jamesjomuad/laser-counter/docs/diagrams/tlc555.jpg

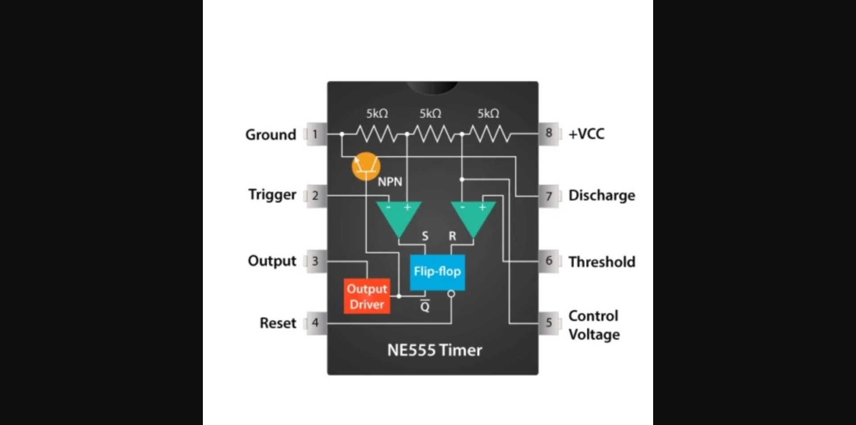
docs/diagrams/tlc555.jpg
