jamesjomuad/laser-counter/docs/diagrams/Monosnap wiring_diagram.svg - Google Chrome 2026-0.jpg

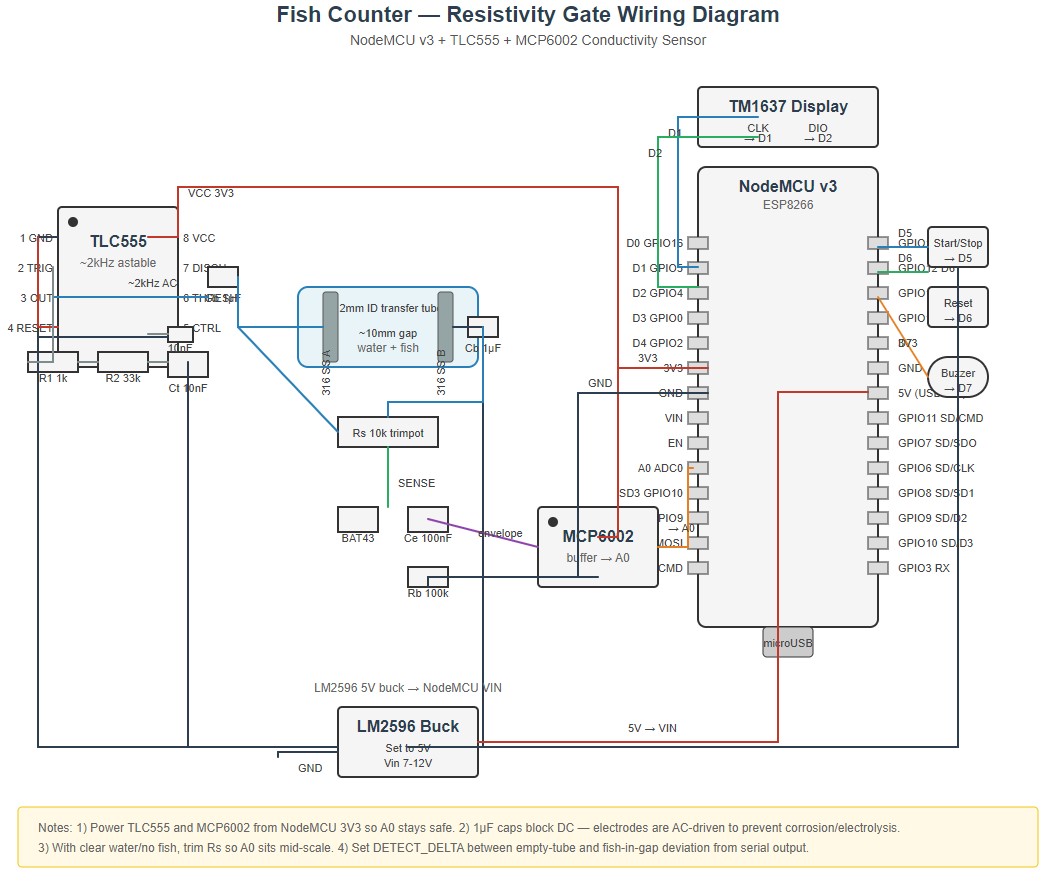
docs/diagrams/Monosnap wiring_diagram.svg - Google Chrome 2026-0.jpg
