jamesjomuad/laser-counter/(commit log)

2026-06-03 Initial commit: laser beam counter for ESP8266
2026-06-14 Switch sensor from laser beam-break to conductivity gate
    Replace the laser/LDR beam-break sensor with an electrical conductivity
    (resistivity) gate for counting tilapia fingerlings through a 12mm
    water-filled tube, where the laser refracts and translucent fish don't
    reliably break the beam.
    - Detection: self-calibrating baseline + deviation (DETECT_DELTA) with a
    sustained-clear re-arm, replacing the fixed THRESHOLD
    - Add resistivity_sensor.md (electrode/circuit design + BOM)
    - Update CLAUDE.md and pins.md: hardware table, pin map, API routes,
    constants, and the previously-undocumented D5 start/stop button
2026-07-10 Rename AP to FishCounter-Setup, add serial RESETWIFI command, disable captive portal, add developer credit to dashboard
    - Rename WiFi AP from LaserCounter-Setup to FishCounter-Setup
    - Add RESETWIFI/CLEARWIFI serial command to clear saved WiFi credentials
    - Add clearWifiSettings() function to wifi_dashboard
    - Disable WiFiManager captive portal so custom dashboard serves at 192.168.4.1
    - Add 'Developed by James' credit to web dashboard
    - Update dashboard page title from 'Laser Counter' to 'Fish Counter'
    - Update setup.md and AGENTS.md with new AP name and serial command docs
    [firsh_counter.ino, wifi_dashboard.cpp, wifi_dashboard.h]
2026-07-12 Fix TM1637 showNumberDec calls to write all 4 digits
    All display calls passed which mapped to
    , so only the first digit was written and the other three
    displayed random segments. Changed to to write
    all four digits with leading zeros.
    Also added serial command for manual count increment.
    [firsh_counter.ino]
2026-07-12 Boot countdown animation and Digital-7 web font
    - Boot shows 8888..7777..0000 countdown on TM1637
    - Web dashboard count uses Digital-7 Mono font for 7-segment look
    - Fixed all showNumberDec calls to use (value, true, 4)
    - Added serial ADD <n> command for manual increment
    [firsh_counter.ino, wifi_dashboard.cpp]
2026-07-13 fix Reset button wiring in SVG: connect D6 signal and GND properly
2026-07-13 expand pins.md into full wiring table covering all components
2026-07-13 wiring table updates
2026-07-13 add anti-stuck baseline recovery when sensor is persistently broken
    [firsh_counter.ino]
2026-07-13 raise DETECT_DELTA to 300 to stop false triggers from electrical noise
    [firsh_counter.ino]
2026-07-13 add EMA noise filter on analog sensor reading to reduce false triggers
    [firsh_counter.ino]
2026-07-13 add 100nF noise filter cap from A0 to GND to wiring diagram SVG
2026-07-15 Add TSOP38238 IR beam-break sensor diagram
    - docs/diagrams/ir_sensor.md: full wiring tables, ASCII diagram, BOM,
    firmware changes, and tuning guide for TSOP38238-based alternative
    - AGENTS.md: reference new diagram, add D8 IR sensor pin to pin map
2026-07-15 Replace polling with non-blocking SSE for web dashboard
    - wifi_dashboard.cpp: handleSSE() now sends headers and returns
    immediately instead of blocking the main loop
    - New handleSSEClients() pushes status (200ms) and log (1.5s)
    events from the main loop via raw HTTP chunked writes
    - HTML/JS uses EventSource with named events (status, log)
    instead of setInterval polling
    - firsh_counter.ino: calls handleSSEClients() each loop iteration
    - wifi_dashboard.h: expose handleSSEClients()
    The main loop keeps running at ~200 Hz — sensor reading, fish
    detection, buttons, and serial commands are unaffected by an
    open dashboard tab.
    [firsh_counter.ino, wifi_dashboard.cpp, wifi_dashboard.h]
2026-07-15 Migrate to ESPAsyncWebServer with non-blocking SSE
    - wifi_dashboard: replace ESP8266WebServer with AsyncWebServer +
    AsyncEventSource for non-blocking SSE pushes from main loop
    - Add wifi_setup.h/cpp — separate TU for WiFiManager to avoid
    enum conflict between ESPAsyncWebServer and ESP8266WebServer
    - firsh_counter.ino: remove server.handleClient(), call
    handleSSEClients() instead
    - AGENTS.md: update build commands, library deps, entrypoints
    Main loop now runs uninterrupted while SSE pushes status (200ms)
    and log (1.5s) events to all connected dashboard clients.
    [firsh_counter.ino, wifi_dashboard.cpp, wifi_dashboard.h, wifi_setup.cpp, wifi_setup.h]
2026-07-15 Add TM1637 bus reset sequence in setup to recover from stuck display state
    [firsh_counter.ino]
2026-07-15 Remove TM1637 bus reset sequence — loose wire was the real cause
    [firsh_counter.ino]
2026-07-22 Add IR sensor support, dashboard log improvements, and doc updates
    - Add IR_PIN (D8) with digital read in main loop, exposed via SSE as ir_detected
    - Flip IR logic to HIGH=obstacle after testing feedback
    - Fix web dashboard Reset to clear log buffer (logHead/logCount)
    - Clear Live Log display immediately on client side on reset
    - Increase Live Log display height from 180px to 360px
    - Log IR state (OBST/CLR) in serial debug output every 500ms
    - Add IR sensor pin to docs/diagrams/pins.md and AGENTS.md
    [firsh_counter.ino, wifi_dashboard.cpp, wifi_dashboard.h]
